laszuba/binary_watch/pcb/binary_watch_dev_pcb.csv

Reference | Value | Footprint | Datasheet | Manufacturer P/N | Vendor P/N
U1 | ATMEGA168PA-A | SMD_Packages:TQFP-32
BT1 | CR2032 | _ Custom Lib:CR2032_MPD |  | BU2032SM-HD-G | BU2032SM-HD-GCT-ND
C5 | 1uF | Capacitors_SMD:C_0603 |  | LMK107B7105KA-T | 587-1242-1-ND
C4 | 1uF | Capacitors_SMD:C_0603 |  | LMK107B7105KA-T | 587-1242-1-ND
C3 | 1uF | Capacitors_SMD:C_0603 |  | LMK107B7105KA-T | 587-1242-1-ND
DM1 | LED | LEDs:LED-0805
R12 | 10k | Resistors_SMD:R_0402
X1 | 32.768kHz | _ Custom Lib:XTAL_ABS07 |  | ABS07-32.768KHZ-9-T | 535-9544-1-ND
SW1B1 | BUTTON_1 | _ Custom Lib:PUSHBUTTON_CK_PTS |  | PTS645SM43SMTR92 LFS | CKN9112CT-ND
SW2A1 | BUTTON_2 | _ Custom Lib:EVQ-P7C01P |  | EVQ-P7C01P | P16765CT-ND
R13 | 10k | Resistors_SMD:R_0402
R1 | 100R | Resistors_SMD:R_0402
DM2 | LED | LEDs:LED-0805
R2 | 100R | Resistors_SMD:R_0402
DM3 | LED | LEDs:LED-0805
R3 | 100R | Resistors_SMD:R_0402
DM4 | LED | LEDs:LED-0805
R4 | 100R | Resistors_SMD:R_0402
DM5 | LED | LEDs:LED-0805
R5 | 100R | Resistors_SMD:R_0402
DM6 | LED | LEDs:LED-0805
R6 | 100R | Resistors_SMD:R_0402
DH7 | LED | LEDs:LED-0805
R7 | 100R | Resistors_SMD:R_0402
DH8 | LED | LEDs:LED-0805
R8 | 100R | Resistors_SMD:R_0402
DH9 | LED | LEDs:LED-0805
R9 | 100R | Resistors_SMD:R_0402
DH10 | LED | LEDs:LED-0805
R10 | 100R | Resistors_SMD:R_0402
DH11 | LED | LEDs:LED-0805
R11 | 100R | Resistors_SMD:R_0402
C6 | 9pF | Capacitors_SMD:C_0402 |  | GRM1555C1H9R0BA01D | 490-6257-1-ND
C7 | 9pF | Capacitors_SMD:C_0402 |  | GRM1555C1H9R0BA01D | 490-6257-1-ND
P1 | ISP | Pin_Headers:Pin_Header_Straight_2x03
R15 | 10R | Resistors_SMD:R_0805_HandSoldering |  | RL1220S-100-F | RL12S10.0FCT-ND
R19 | 10k | Resistors_SMD:R_0603_HandSoldering
R16 | 0R1 | Resistors_SMD:R_0805_HandSoldering |  | RL1220S-R10-F | RL12S.10FCT-ND
C8 | 1uF | Capacitors_SMD:C_0603_HandSoldering |  | LMK107B7105KA-T | 587-1242-1-ND
P7 | MCU_ISENSE | Pin_Headers:Pin_Header_Straight_1x02
D1 | LED | LEDs:LED-0805
R14 | 240R | Resistors_SMD:R_0603_HandSoldering
K1 | PWR_SELECT | Pin_Headers:Pin_Header_Straight_1x03 |  | M20-9990345 | 952-2263-ND
SW3 | RESET | _ Custom Lib:PUSHBUTTON_CK_PTS |  | PTS645SM43SMTR92 LFS | CKN9112CT-ND
P2 | USB-MICRO-B | _ Custom Lib:MICRO_USB_FCI |  | 10118193-0001LF | 609-4616-1-ND
R17 | 120R | Resistors_SMD:R_0603_HandSoldering |  |  | P120HCT-ND
R18 | 169R | Resistors_SMD:R_0603_HandSoldering |  |  | P169HCT-ND
C10 | 1uF | Capacitors_SMD:C_0603_HandSoldering |  | LMK107B7105KA-T | 587-1242-1-ND
C9 | 22uF | Capacitors_SMD:c_elec_4x4.5 |  | EDK226M016A9BAA | 399-11437-1-ND
C12 | 22uF | Capacitors_SMD:c_elec_4x4.5 |  | EDK226M016A9BAA | 399-11437-1-ND
F1 | 0.1A | Resistors_SMD:R_1206_HandSoldering |  | 0ZCA0010FF2E | 507-1477-1-ND
P9 | TST | Measurement_Points:Measurement_Point_Round-TH_Big |  | 5001 | 5001K-ND
P8 | TST | Measurement_Points:Measurement_Point_Round-TH_Big |  | 5001 | 5001K-ND
M1 | MNT | _ Custom Lib:MNT_3.5MM
M2 | MNT | _ Custom Lib:MNT_3.5MM
M3 | MNT | _ Custom Lib:MNT_3.5MM
M4 | MNT | _ Custom Lib:MNT_3.5MM
U4 | INA213 | Transistors_SMD:sc70-6 |  | INA213AIDCKR | 296-26072-1-ND
C11 | 0.1uF | Capacitors_SMD:C_0603_HandSoldering |  | LMK107B7105KA-T | 587-1242-1-ND
P3 | LED_ISENSE | Pin_Headers:Pin_Header_Straight_1x02
U2 | INA210 | Transistors_SMD:sc70-6 |  | INA210AIDCKT | 296-23420-1-ND
C2 | 0.1uF | Capacitors_SMD:C_0603_HandSoldering |  | LMK107B7105KA-T | 587-1242-1-ND
R20 | 240R | Resistors_SMD:R_0603_HandSoldering
SW1A1 | BUTTON_1 | _ Custom Lib:EVQ-P7C01P |  | EVQ-P7C01P | P16765CT-ND
SW2B1 | BUTTON_2 | _ Custom Lib:PUSHBUTTON_CK_PTS |  | PTS645SM43SMTR92 LFS | CKN9112CT-ND
C1 | 1uF | Capacitors_SMD:C_0603_HandSoldering |  | LMK107B7105KA-T | 587-1242-1-ND
NET1 | NET_CONN | _ Custom Lib:NET_CONN
NET2 | NET_CONN | _ Custom Lib:NET_CONN
NET3 | NET_CONN | _ Custom Lib:NET_CONN
NET4 | NET_CONN | _ Custom Lib:NET_CONN
U3 | NCP1117ST33T3G | _ Custom Lib:SOT-223 |  | NCP1117STAT3G | NCP1117STAT3GOSCT-ND
