laszuba/binary_watch/pcb/binary_watch_pcb.pdf

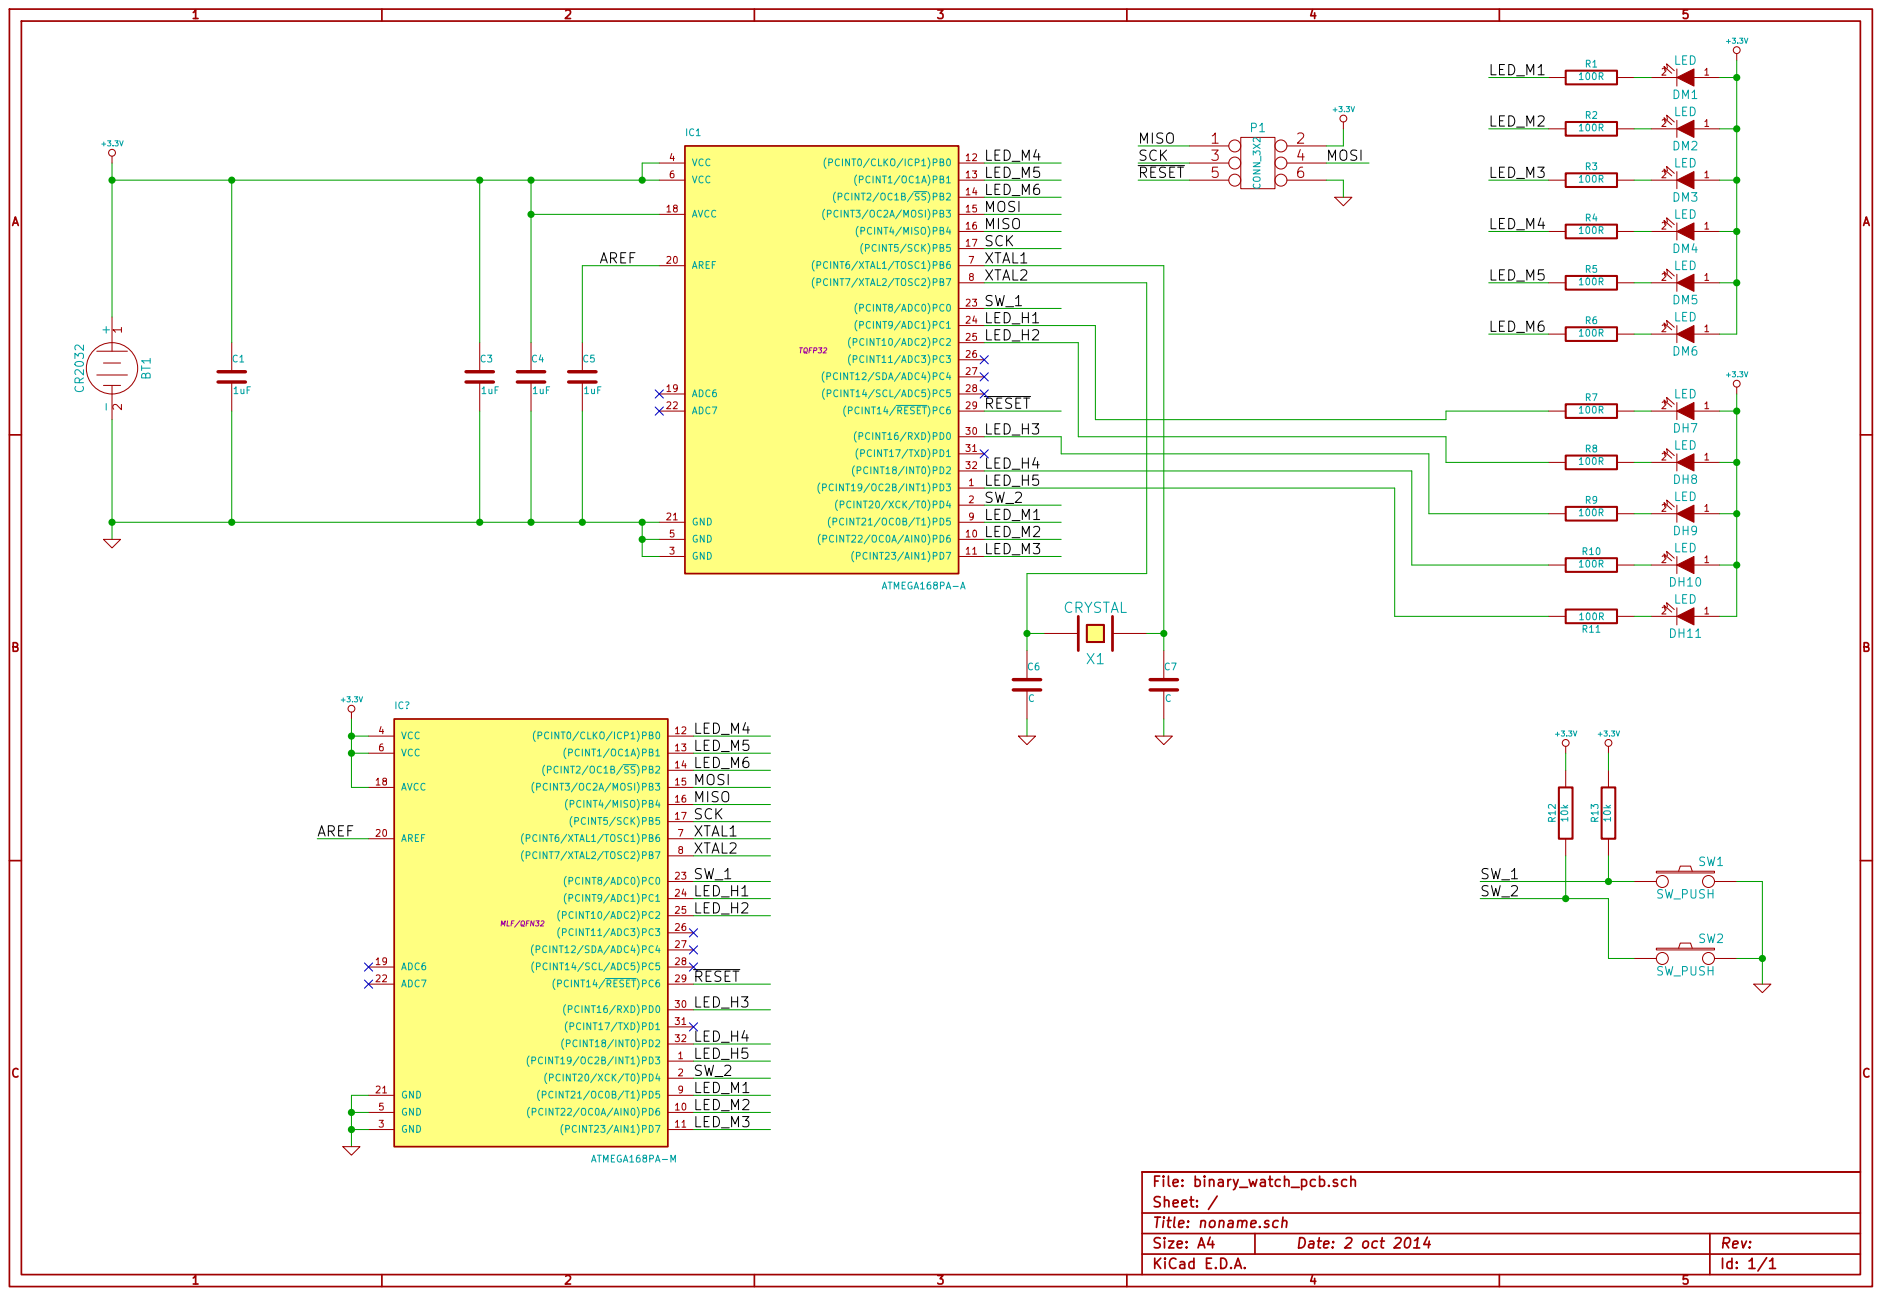
[picture p1: page 1]

LED_H1
LED_H2

Id: 1/1 Title: noname.sch File: binary_watch_pcb.sch
Sheet: /
