laszuba/binary_watch/pcb/binary_watch_dev_pcb.pdf

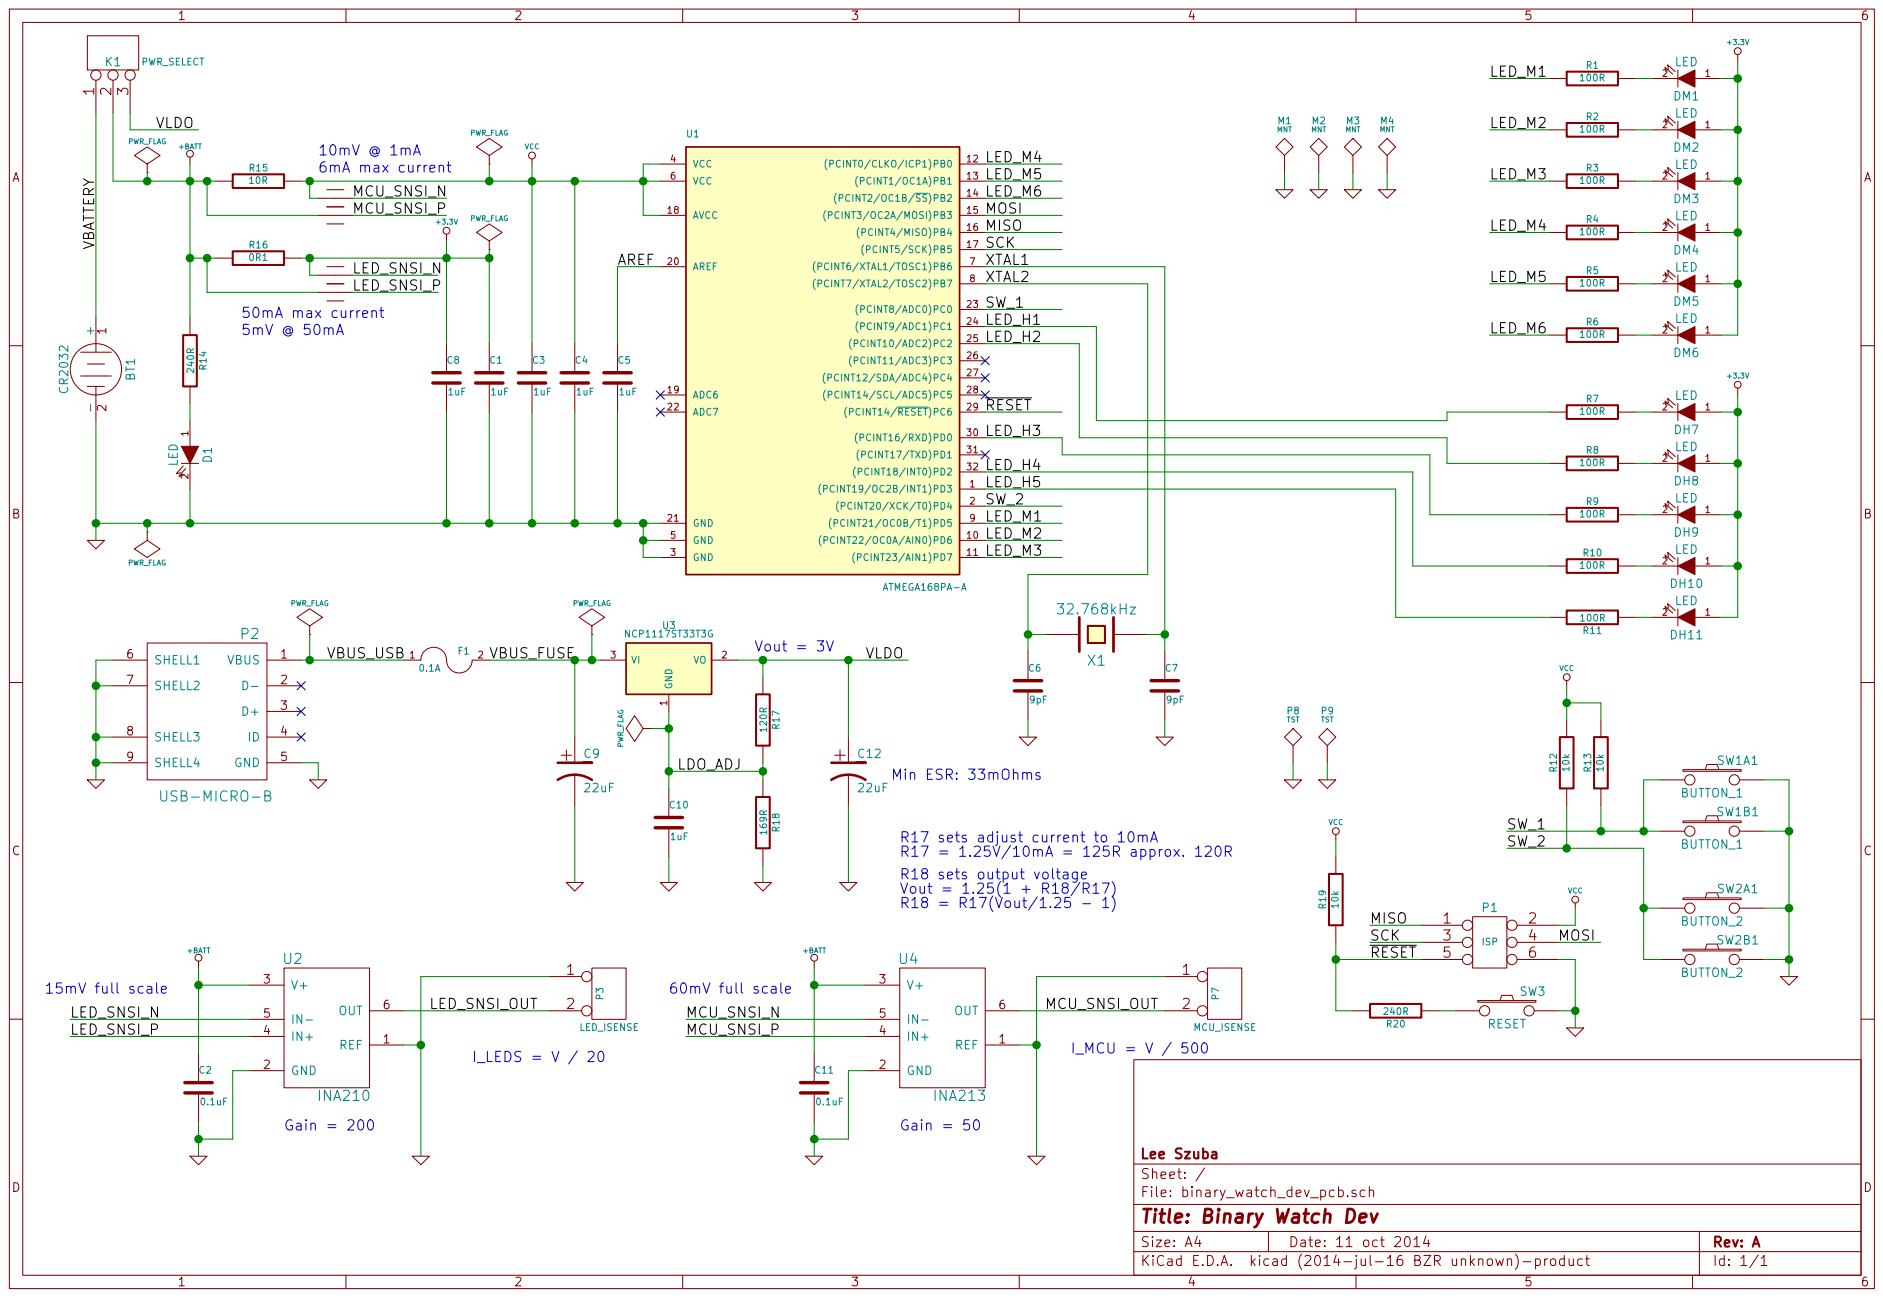
[picture p2: page 1]

File: binary_watch_dev_pcb.sch Sheet: / Lee Szuba

Id: 1/1 Title: Binary Watch Dev
