laszuba/binary_watch/pcb/binary_watch_pcb.kicad_pcb

## KiCad design pcb/binary_watch_pcb.kicad_pcb (2015-05-22)

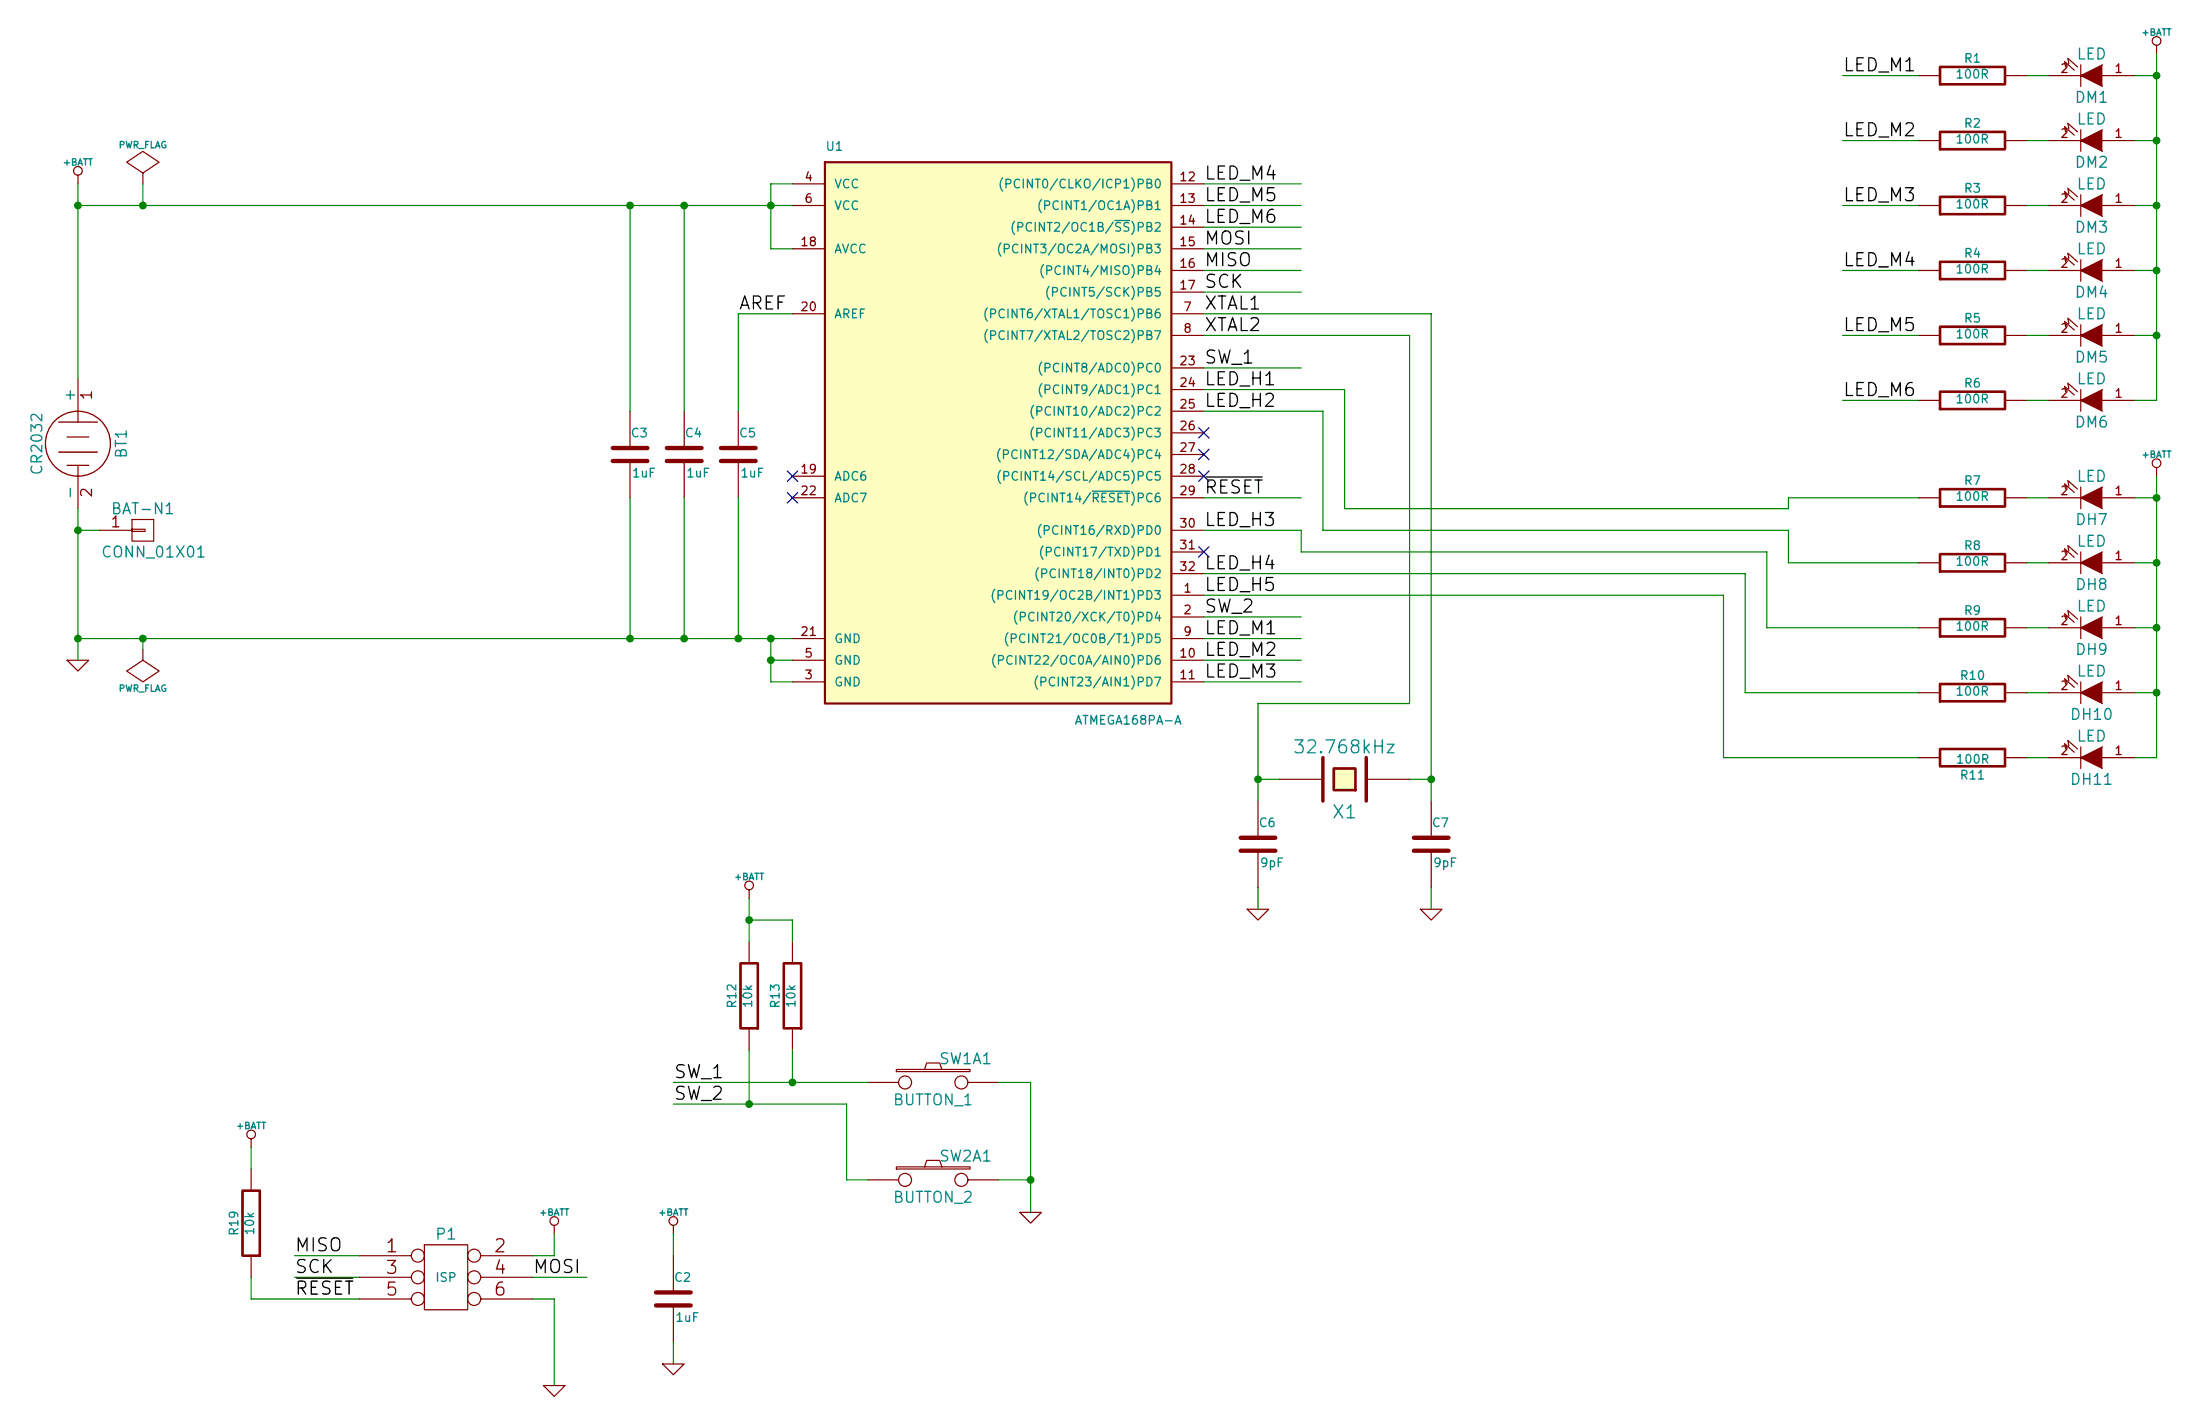
[picture p3: schematic binary_watch_pcb.sch, Binary Watch]

Parts:
BAT-N1: CONN_01X01
BT1: CR2032; CR2032_MPD; Manufacturer P/N BU2032SM-HD-G
C2, C3, C4, C5: 1uF; C_0603; Manufacturer P/N LMK107B7105KA-T
C6, C7: 9pF; C_0402; Manufacturer P/N GRM1555C1H9R0BA01D
DH7, DH8, DH9, DH10, DH11: LED; LED-0805
DM1, DM2, DM3, DM4, DM5, DM6: LED; LED-0805
P1: ISP; Pin_Header_Straight_2x03
R1, R2, R3, R4, R5, R6, R7, R8, R9, R10, R11: 100R; R_0402
R12, R13, R19: 10k; R_0402
SW1A1: BUTTON_1; EVQ-P7C01P; Manufacturer P/N EVQ-P7C01P
SW2A1: BUTTON_2; EVQ-P7C01P; Manufacturer P/N EVQ-P7C01P
U1: ATMEGA168PA-A; TQFP-32
X1: 32.768kHz; XTAL_ABS07; Manufacturer P/N ABS07-32.768KHZ-9-T

Connections:
+BATT: BT1.1 (+), C2.1, C3.1, C4.1, DH7.1 (A), DH8.1 (A), DH9.1 (A), DH10.1 (A), DH11.1 (A), DM1.1 (A), DM2.1 (A), DM3.1 (A), DM4.1 (A), DM5.1 (A), DM6.1 (A), P1.2, R12.2, R13.2, R19.2, U1.4 (VCC), U1.6 (VCC), U1.18 (AVCC)
/AREF: C5.1, U1.20 (AREF)
/LED_H1: R7.1, U1.24 ((PCINT9/ADC1)PC1)
/LED_H2: R8.1, U1.25 ((PCINT10/ADC2)PC2)
/LED_H3: R9.1, U1.30 ((PCINT16/RXD)PD0)
/LED_H4: R10.1, U1.32 ((PCINT18/INT0)PD2)
/LED_H5: R11.2, U1.1 ((PCINT19/OC2B/INT1)PD3)
/LED_M1: R1.1, U1.9 ((PCINT21/OC0B/T1)PD5)
/LED_M2: R2.1, U1.10 ((PCINT22/OC0A/AIN0)PD6)
/LED_M3: R3.1, U1.11 ((PCINT23/AIN1)PD7)
/LED_M4: R4.1, U1.12 ((PCINT0/CLKO/ICP1)PB0)
/LED_M5: R5.1, U1.13 ((PCINT1/OC1A)PB1)
/LED_M6: R6.1, U1.14 ((PCINT2/OC1B/~SS~)PB2)
/MISO: P1.1, U1.16 ((PCINT4/MISO)PB4)
/MOSI: P1.4, U1.15 ((PCINT3/OC2A/MOSI)PB3)
/SCK: P1.3, U1.17 ((PCINT5/SCK)PB5)
/SW_1: R13.1, SW1A1.1, U1.23 ((PCINT8/ADC0)PC0)
/SW_2: R12.1, SW2A1.1, U1.2 ((PCINT20/XCK/T0)PD4)
/XTAL1: C7.1, U1.7 ((PCINT6/XTAL1/TOSC1)PB6), X1.1
/XTAL2: C6.1, U1.8 ((PCINT7/XTAL2/TOSC2)PB7), X1.2
/~RESET: P1.5, R19.1, U1.29 ((PCINT14/~RESET~)PC6)
GND: BAT-N1.1, BT1.2 (-), C2.2, C3.2, C4.2, C5.2, C6.2, C7.2, P1.6, SW1A1.2, SW2A1.2, U1.3 (GND), U1.5 (GND), U1.21 (GND)
unnamed: DH7.2 (K), R7.2
unnamed: DH8.2 (K), R8.2
unnamed: DH9.2 (K), R9.2
unnamed: DH10.2 (K), R10.2
unnamed: DH11.2 (K), R11.1
unnamed: DM1.2 (K), R1.2
unnamed: DM2.2 (K), R2.2
unnamed: DM3.2 (K), R3.2
unnamed: DM4.2 (K), R4.2
unnamed: DM5.2 (K), R5.2
unnamed: DM6.2 (K), R6.2

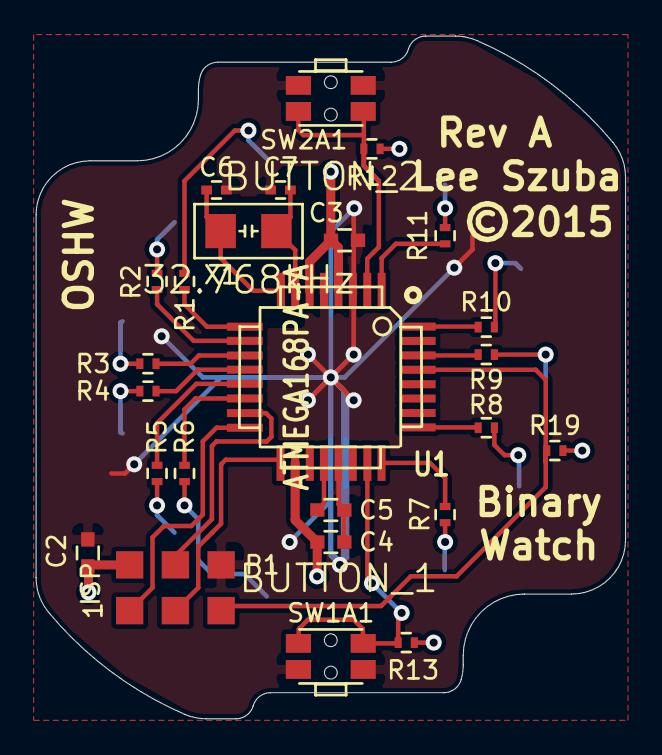
[picture p4: board binary_watch_pcb.kicad_pcb from above]

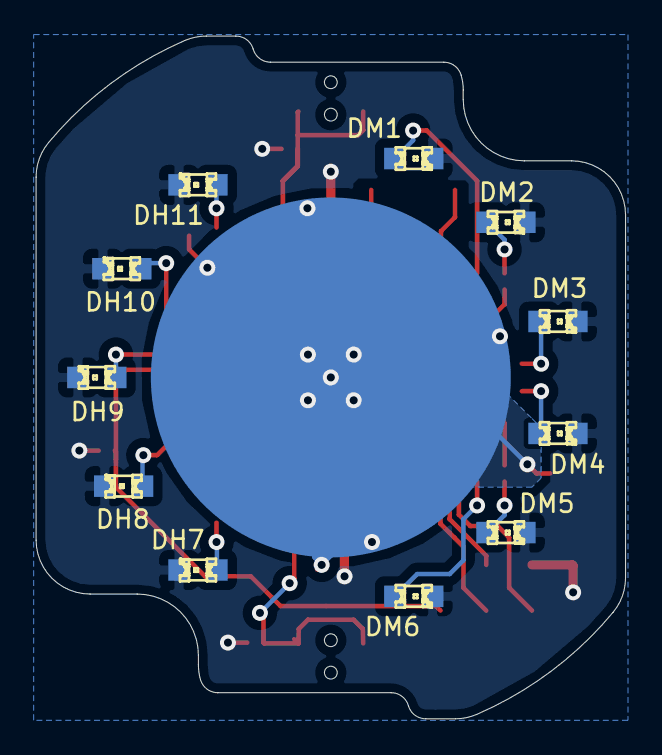
[picture p5: board binary_watch_pcb.kicad_pcb from below]

Board: 2 copper layers, 32.7 x 37.9 mm, 37 parts (12 on the bottom side), 33 nets.
