laszuba/binary_watch/pcb/circuit_board_outline-append.kicad_pcb

## KiCad design pcb/circuit_board_outline-append.kicad_pcb (2014-10-02)

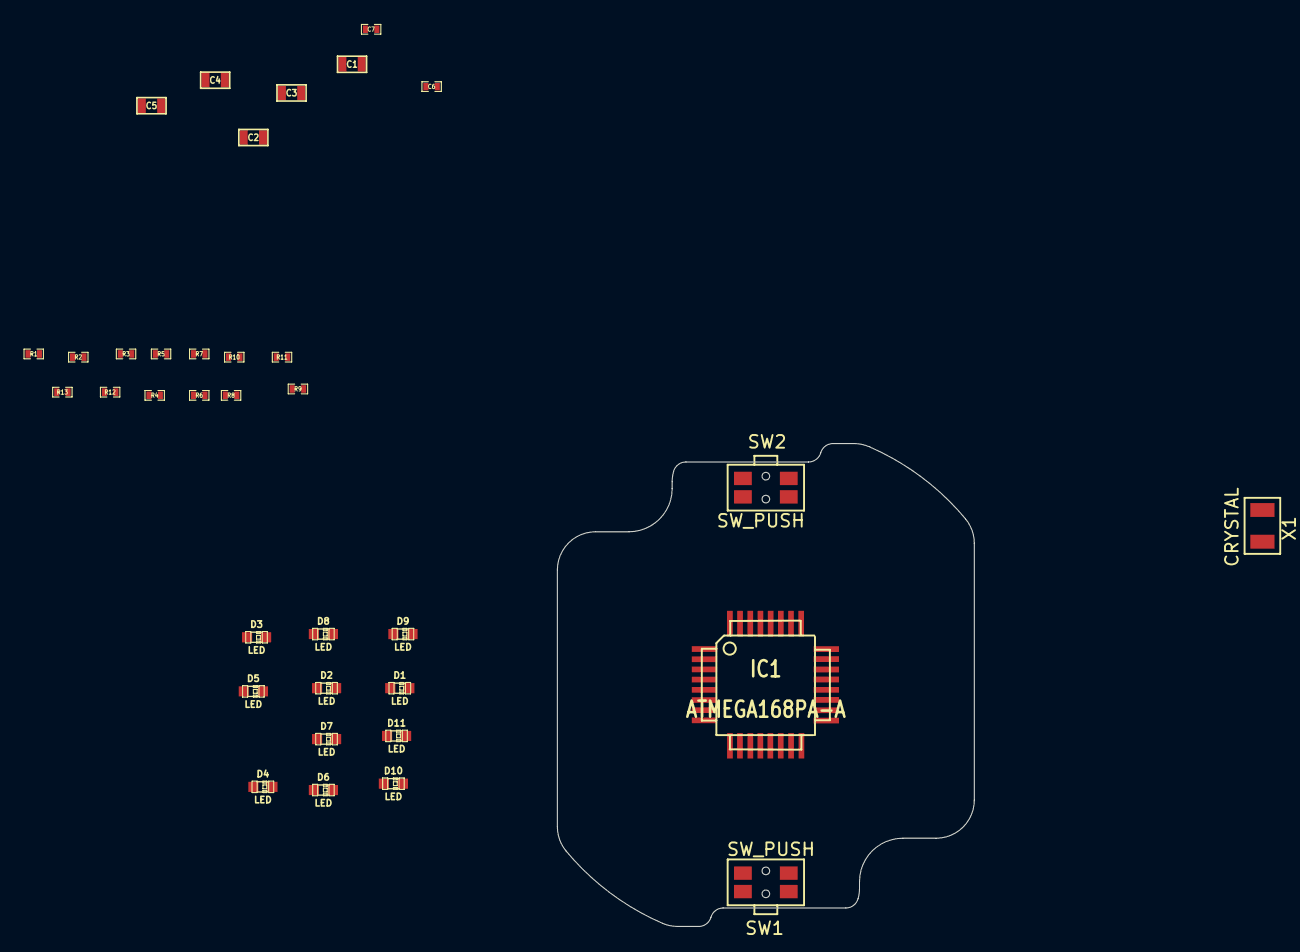
[picture p6: board circuit_board_outline-append.kicad_pcb from above]

Board: 2 copper layers, 32.7 x 37.9 mm, 35 parts (0 on the bottom side), 29 nets, no tracks yet.

Parts:
C1, C2, C3, C4, C5: 1uF; SM0603
C6, C7: C; SM0402
D1, D2, D3, D4, D5, D6, D7, D8, D9, D10, D11: LED; LED-0603
IC1: ATMEGA168PA-A; TQFP32
R1, R2, R3, R4, R5, R6, R7, R8, R9, R10, R11: 100R; SM0402
R12, R13: 10k; SM0402
SW1, SW2: SW_PUSH; EVQP7
X1: CRYSTAL; ADS07

Connections:
+3.3V: C1.1, C2.1, C3.1, C4.1, IC1.4, IC1.6, IC1.18, R1.2, R2.2, R3.2, R4.2, R5.2, R6.2, R7.2, R8.2, R9.2, R10.2, R11.2, R12.2, R13.2
GND: C1.2, C2.2, C3.2, C4.2, C5.2, C6.2, C7.2, IC1.3, IC1.5, IC1.21, SW1.2, SW2.2
unnamed: D9.2, IC1.25
unnamed: D3.2, IC1.14
unnamed: D4.2, IC1.15
unnamed: D5.2, IC1.16
unnamed: D6.1, R6.1
unnamed: D6.2, IC1.17
unnamed: D7.1, R7.1
unnamed: D7.2, IC1.23
unnamed: D8.1, R8.1
unnamed: D8.2, IC1.24
unnamed: D9.1, R9.1
unnamed: D2.2, IC1.13
unnamed: D10.1, R10.1
unnamed: D10.2, IC1.26
unnamed: D11.1, R11.1
unnamed: D11.2, IC1.27
unnamed: C5.1, IC1.20
unnamed: D1.1, R1.1
unnamed: IC1.10, R13.1, SW1.1
unnamed: IC1.11, R12.1, SW2.1
unnamed: D1.2, IC1.12
unnamed: D2.1, R2.1
unnamed: D3.1, R3.1
unnamed: D4.1, R4.1
unnamed: D5.1, R5.1
unnamed: C6.1, IC1.8, X1.2
unnamed: C7.1, IC1.7, X1.1
