laszuba/binary_watch/src/disp_time.h

#ifndef _DISP_TIME_H
#define _DISP_TIME_H

/**************************************************
 * Macros
 **************************************************/

/**************************************************
 * Enums/Struts
 **************************************************/

/**************************************************
 * Public Functions
 **************************************************/

void disp_time(uint8_t);

void mins_off(void);
void hours_off(void);
void disp_off(void);
void disp_on(void);

#endif /* _DISP_TIME_H */
