laszuba/binary_watch/(commit log)

2014-10-02 add pcb files
    [binary_watch_pcb.kicad_pcb, binary_watch_pcb.sch, circuit_board_outline-append.kicad_pcb, circuit_board_outline.kicad_pcb]
2014-10-12 Update to latest kicad version, create footprints.
    [binary_watch_dev_pcb.kicad_pcb, binary_watch_dev_pcb.sch]
2014-10-12 Move to 5x5 board for cost
    [$binary_watch_dev_pcb.sch, binary_watch_dev_pcb.kicad_pcb]
2014-11-05 Add new dev pcb files from nightly build of kicad
    [binary_watch_dev_pcb.sch]
2014-11-14 Finish dev schematic and layout, create gerbers to send to manufacture
    [binary_watch_dev_pcb.kicad_pcb, binary_watch_dev_pcb.sch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]
2014-12-07 Add makefile, get first running code to PWM LEDs
    [$binary_watch_dev_pcb.sch, binary_watch_dev_pcb.csv, binary_watch_dev_pcb.sch]
2014-12-07 Remove unneeded kicad files (backups, etc.)
2014-12-12 Refactor debouncing code to hopefully be a little more durable across interrupts
2015-05-22 Gen fab outputs, pdfs, and finish final routing.
    [binary_watch_dev_pcb.sch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]
