laszuba/binary_watch/(notices)

Notices in the files:
pcb/binary_watch_pcb.kicad_pcb:
©2015
